suspaceflight/rocket-logger/rocket-logger-basic.brd

## EAGLE design rocket-logger-basic.brd (2015-02-23)

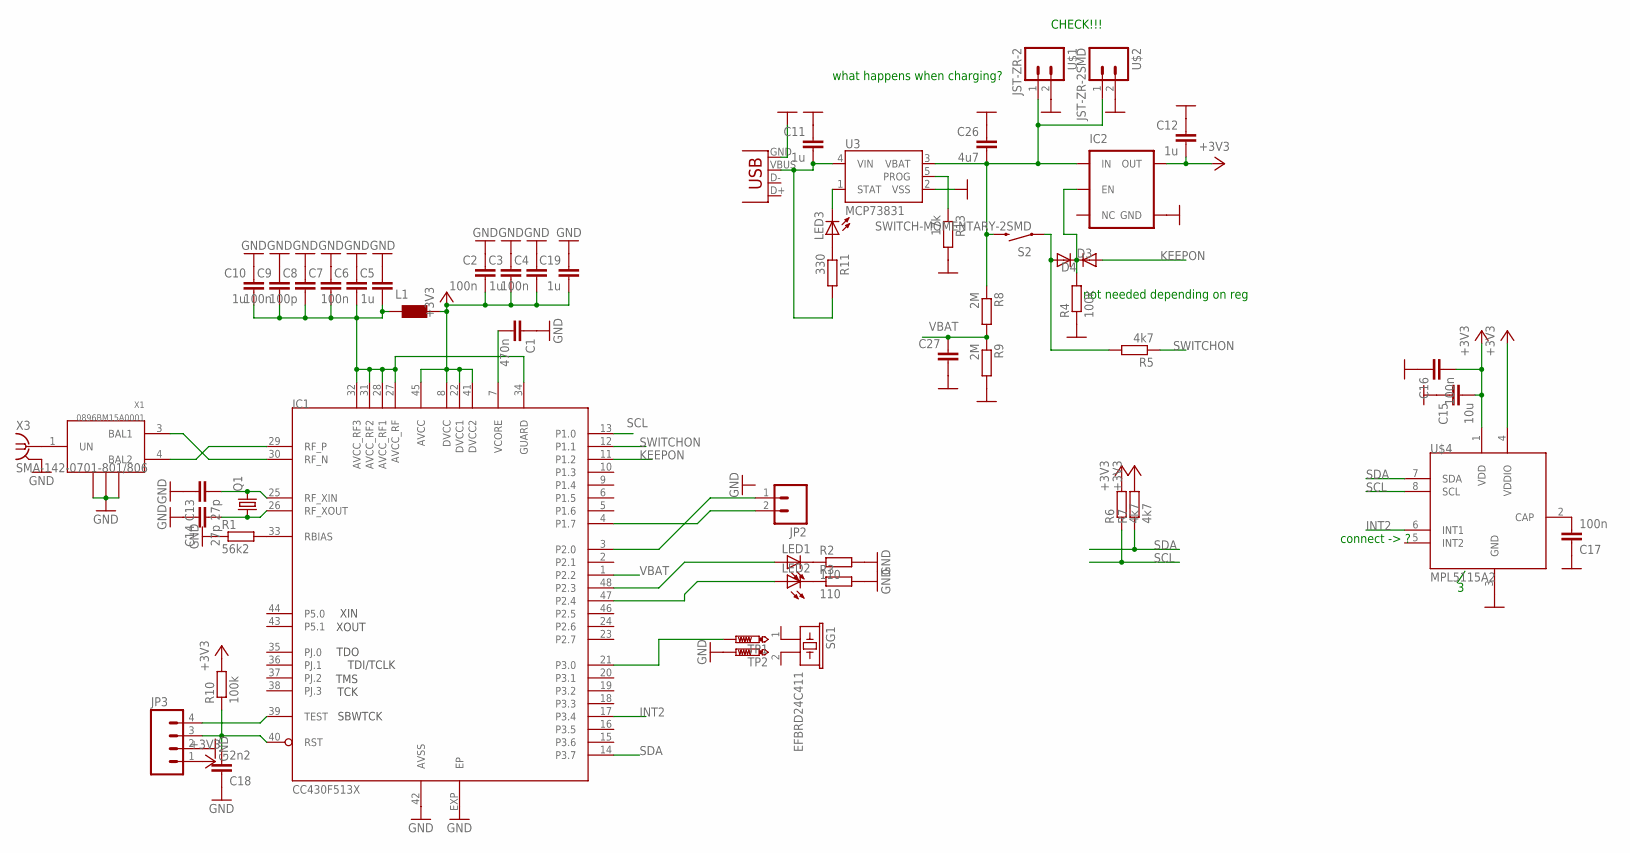
[picture p1: schematic rocket-logger-basic.sch]

Parts:
C1: 470n; C0402
C2, C4, C6, C9, C16, C17: 100n; C0402
C3, C5, C10, C11, C12, C19: 1u; C0402
C7, C27: C-EUC0402; C0402
C8: 100p; C0402
C13, C14: 27p; C0402
C15: 10u; C0402
C18: 2n2; C0402
C26: 4u7; C0402
D3, D4: DIODE-SOD523; SOD523
IC1: CC430F513X; QFN48
IC2: V_REG_TPS76433SOT23-5; SOT23-5
JP2: M02PTH; 1X02
JP3: M04PTH; 1X04
L1: WE-MK_0603; 0603
LED1, LED2, LED3: LED0603; LED-0603
Q1: CRYSTAL5X3; CRYSTAL-SMD-5X3
R1: 56k2; R0402
R2, R3: 110; R0402
R4, R10: 100k; R0402
R5, R6, R7: 4k7; R0402
R8, R9: 2M; R0402
R11: 330; R0402
R13: 17k; R0402
S2: SWITCH-MOMENTARY-2SMD; TACTILE_SWITCH_SMD
SG1: EFBRD24C411
TP1, TP2: PTR1B1,27; B1,27
U3: MCP73831; SOT23-5
U$1: JST-ZR-2
U$2: JST-ZR-2SMD; JST-ZR-2-SMD
U$4: MPL5115A2; LGA8
X1: 0896BM15A0001
X2: USB-MICROB
X3: SMA-142-0701-801/806; J502-ND-142-0701-801/806

Connections:
+3V3: C2.2, C3.2, C4.2, C12.2, C15.2, C16.2, C19.2, IC1.8 (DVCC), IC1.22 (DVCC1), IC1.41 (DVCC2), IC1.45 (AVCC), IC2.5 (OUT), JP3.1, L1.2, R6.2, R7.2, R10.2, U$4.1 (VDD), U$4.4 (VDDIO)
AVCC_RF2: C5.2, C6.2, C7.2, C8.2, C9.2, C10.2, IC1.27 (AVCC_RF), IC1.28 (AVCC_RF1), IC1.31 (AVCC_RF2), IC1.32 (AVCC_RF3), IC1.34 (GUARD), L1.1
GND: C1.1, C2.1, C3.1, C4.1, C5.1, C6.1, C7.1, C8.1, C9.1, C10.1, C11.1, C12.1, C13.1, C14.1, C15.1, C16.1, C17.1, C18.1, C19.1, C26.1, C27.2, IC1.42 (AVSS), IC1.EXP (EP), IC2.2 (GND), JP3.2, R1.1, R2.2, R3.2, R4.1, R9.2, R13.2, TP2.TP, U3.2 (VSS), U$1.2, U$2.2, U$4.3 (GND), X1.2 (GND2), X1.5 (GND), X1.6 (GND1), X2.GND, X3.G@1 (GND), X3.G@2 (GND), X3.G@3 (GND), X3.G@4 (GND)
INT2: IC1.17 (P3.4), U$4.6 (INT1)
KEEPON: D4.A, IC1.11 (P1.2)
unnamed: R13.1, U3.5 (PROG)
unnamed: C26.2, IC2.1 (IN), R8.1, S2.3 (2), U3.3 (VBAT), U$1.1, U$2.1
unnamed: IC1.30 (RF_N), X1.3 (BAL1)
unnamed: IC1.29 (RF_P), X1.4 (BAL2)
unnamed: IC1.33 (RBIAS), R1.2
unnamed: C13.2, IC1.25 (RF_XIN), Q1.3 (2)
unnamed: C14.2, IC1.26 (RF_XOUT), Q1.1
unnamed: X1.1 (UN), X3.1
unnamed: LED1.C, R2.1
unnamed: LED2.C, R3.1
unnamed: IC1.3 (P2.0), JP2.1
unnamed: IC1.4 (P1.7), JP2.2
unnamed: C17.2, U$4.2 (CAP)
unnamed: LED3.A, R11.1
unnamed: IC1.48 (P2.3), LED1.A
unnamed: C11.2, R11.2, U3.4 (VIN), X2.VBUS
unnamed: LED3.C, U3.1 (STAT)
unnamed: IC1.39 (TEST), JP3.4
unnamed: D3.A, R5.2, S2.1
unnamed: D3.C, D4.C, IC2.3 (EN), R4.2
unnamed: C18.2, IC1.40 (RST), JP3.3, R10.1
unnamed: IC1.47 (P2.4), LED2.A
unnamed: IC1.21 (P3.0), TP1.TP
SCL: IC1.13 (P1.0), R6.1, U$4.8 (SCL)
SDA: IC1.14 (P3.7), R7.1, U$4.7 (SDA)
SWITCHON: IC1.12 (P1.1), R5.1
VBAT: C27.1, IC1.1 (P2.2), R8.2, R9.1
VCORE: C1.2, IC1.7 (VCORE)

Notes on the sheet:
CHECK!!!
connect -> ?
what happens when charging?
not needed depending on reg

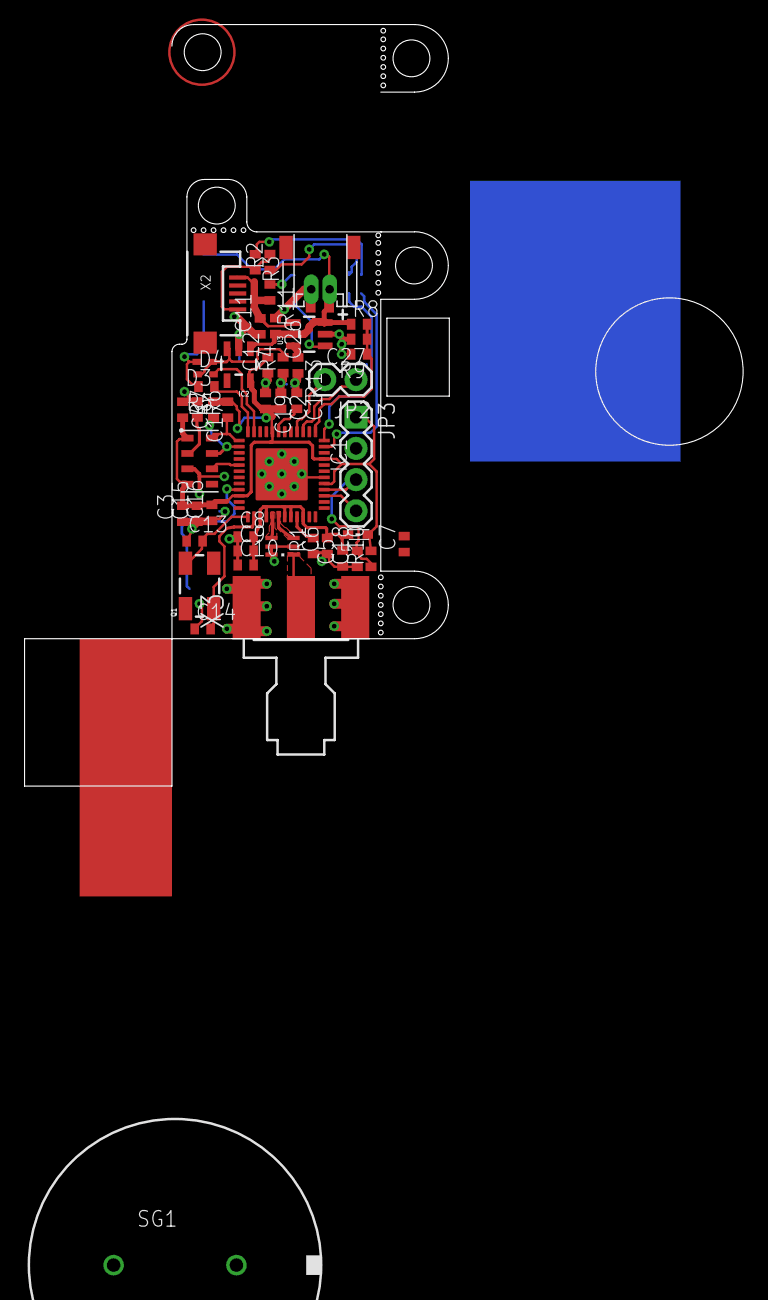
[picture p2: board rocket-logger-basic.brd from above]

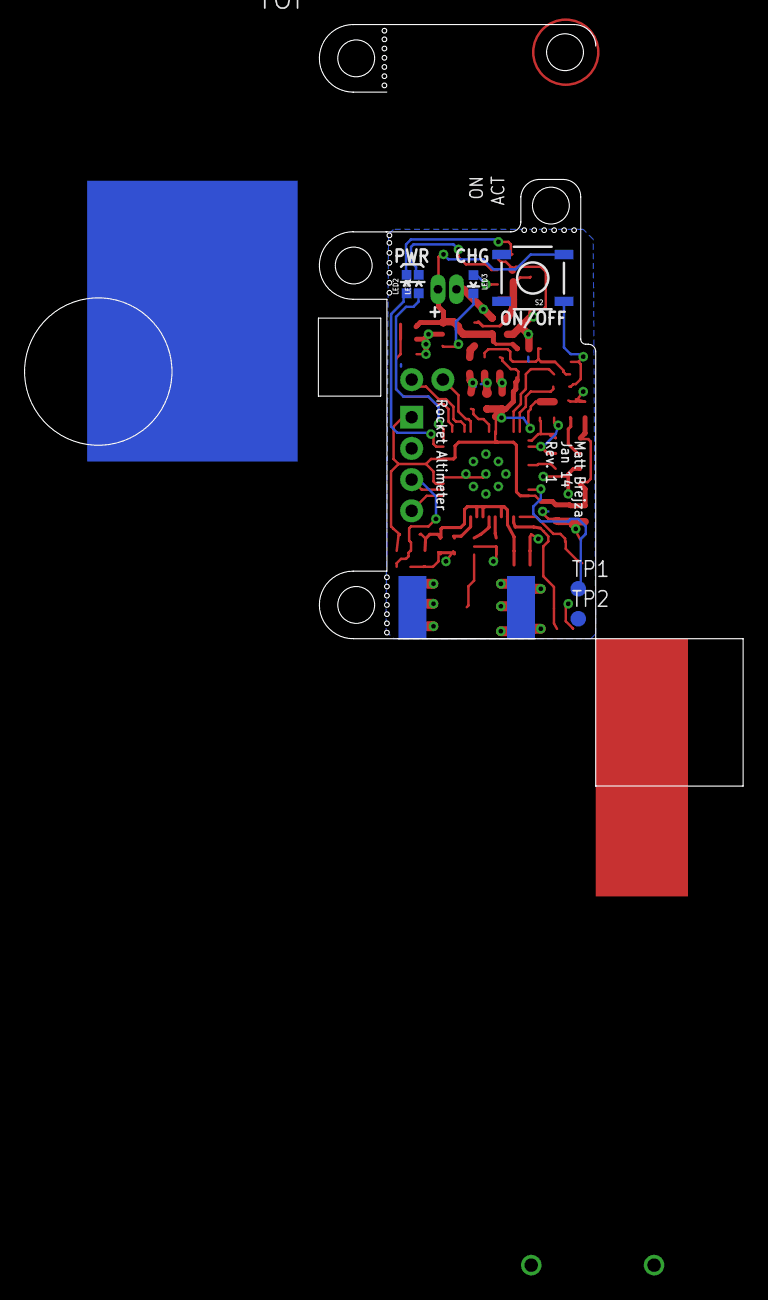
[picture p3: board rocket-logger-basic.brd from below]

Board: 2 copper layers, 34.5 x 49.4 mm, 55 parts (6 on the bottom side), 33 nets.
