suspaceflight/rocket-logger/rocket-logger.brd

## EAGLE design rocket-logger.brd (2014-01-06)

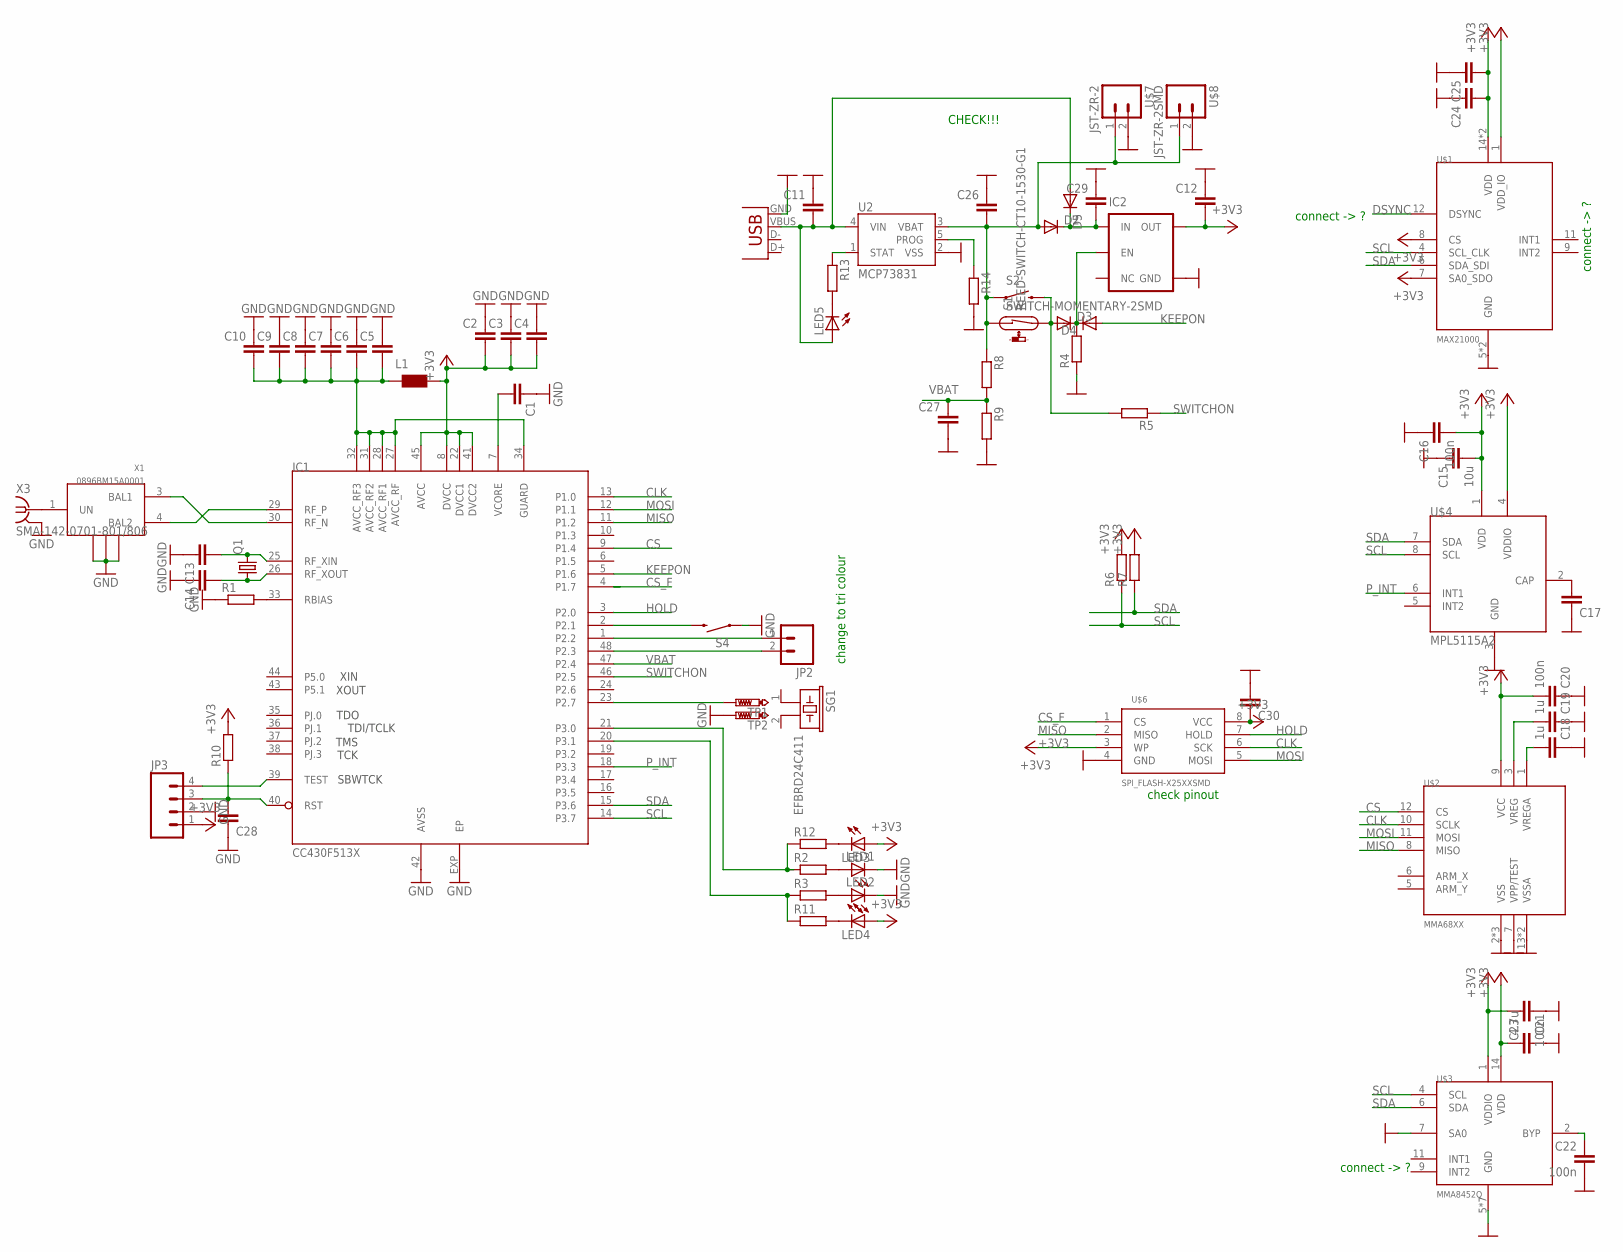
[picture p4: schematic rocket-logger.sch]

Parts:
C1, C2, C3, C4, C5, C6, C7, C8, C9, C10, C11, C12, C13, C14, C17, C24, C25, C26, C27, C28, C29, C30: C-EUC0402; C0402
C15: 10u; C0402
C16, C20, C22, C23: 100n; C0402
C18, C19: 1u; C0402
C21: 4.7u; C0402
D2, D3, D4, D5: DIODE-SOD523; SOD523
IC1: CC430F513X; QFN48
IC2: V_REG_TPS76433SOT23-5; SOT23-5
JP2: M02PTH; 1X02
JP3: M04PTH; 1X04
L1: WE-MK_0603; 0603
LED1, LED2, LED3, LED4, LED5: LED0603; LED-0603
Q1: CRYSTAL5X3; CRYSTAL-SMD-5X3
R1, R2, R3, R4, R5, R6, R7, R8, R9, R10, R11, R12, R13, R14: R-EU_R0402; R0402
S1: REED-SWITCH-CT10-1530-G1; CT10-G1
S2, S4: SWITCH-MOMENTARY-2SMD; TACTILE_SWITCH_SMD
SG1: EFBRD24C411
TP1, TP2: PTR1B1,27; B1,27
U2: MCP73831; SOT23-5
U$1: MAX21000; LGA16
U$2: MMA68XX; QFN16-6X6
U$3: MMA8452Q; QFN16-COL
U$4: MPL5115A2; LGA8
U$6: SPI_FLASH-X25XXSMD; SO08
U$7: JST-ZR-2
U$8: JST-ZR-2SMD; JST-ZR-2-SMD
X1: 0896BM15A0001
X2: USB-MICROB
X3: SMA-142-0701-801/806; J502-ND-142-0701-801/806

Connections:
+3V3: C2.2, C3.2, C4.2, C12.2, C15.2, C16.2, C20.2, C21.2, C23.1, C24.2, C25.2, C30.1, IC1.8 (DVCC), IC1.22 (DVCC1), IC1.41 (DVCC2), IC1.45 (AVCC), IC2.5 (OUT), JP3.1, L1.2, LED3.A, LED4.A, R6.2, R7.2, R10.2, U$1.1 (VDD_IO), U$1.7 (SA0_SDO), U$1.8 (CS), U$1.14 (VDD), U$1.15 (VDD), U$2.9 (VCC), U$3.1 (VDDIO), U$3.14 (VDD), U$4.1 (VDD), U$4.4 (VDDIO), U$6.3 (WP), U$6.8 (VCC)
AVCC_RF2: C5.2, C6.2, C7.2, C8.2, C9.2, C10.2, IC1.27 (AVCC_RF), IC1.28 (AVCC_RF1), IC1.31 (AVCC_RF2), IC1.32 (AVCC_RF3), IC1.34 (GUARD), L1.1
CLK: IC1.13 (P1.0), U$2.10 (SCLK), U$6.6 (SCK)
CS: IC1.9 (P1.4), U$2.12 (CS)
CS_F: IC1.4 (P1.7), U$6.1 (CS)
DSYNC: U$1.12 (DSYNC)
GND: C1.1, C2.1, C3.1, C4.1, C5.1, C6.1, C7.1, C8.1, C9.1, C10.1, C11.1, C12.1, C13.1, C14.1, C15.1, C16.1, C17.1, C18.1, C19.1, C20.1, C21.1, C22.2, C23.2, C24.1, C25.1, C26.1, C27.2, C28.1, C29.1, C30.2, IC1.42 (AVSS), IC1.EXP (EP), IC2.2 (GND), JP3.2, LED1.C, LED2.C, R1.1, R4.1, R9.2, R14.2, S4.1, TP2.TP, U2.2 (VSS), U$1.5 (GND), U$1.10 (GND), U$2.2 (VSS), U$2.4 (VSS), U$2.7 (VPP/TEST), U$2.13 (VSSA), U$2.16 (VSSA), U$2.17 (VSS), U$3.5 (GND), U$3.7 (SA0), U$3.8 (GND), U$3.10 (GND), U$3.12 (GND), U$3.13 (GND), U$3.15 (GND), U$3.16 (GND), U$4.3 (GND), U$6.4 (GND), U$7.2, U$8.2, X1.2 (GND2), X1.5 (GND), X1.6 (GND1), X2.GND, X3.G@1 (GND), X3.G@2 (GND), X3.G@3 (GND), X3.G@4 (GND)
HOLD: IC1.3 (P2.0), U$6.7 (HOLD)
KEEPON: D4.A, IC1.5 (P1.6)
MISO: IC1.11 (P1.2), U$2.8 (MISO), U$6.2 (MISO)
MOSI: IC1.12 (P1.1), U$2.11 (MOSI), U$6.5 (MOSI)
unnamed: C11.2, D5.A, LED5.A, U2.4 (VIN), X2.VBUS
unnamed: C26.2, D2.A, R8.1, S1.1, S2.1, U2.3 (VBAT), U$7.1, U$8.1
unnamed: IC1.30 (RF_N), X1.3 (BAL1)
unnamed: IC1.29 (RF_P), X1.4 (BAL2)
unnamed: IC1.33 (RBIAS), R1.2
unnamed: C13.2, IC1.25 (RF_XIN), Q1.3 (2)
unnamed: C14.2, IC1.26 (RF_XOUT), Q1.1
unnamed: X1.1 (UN), X3.1
unnamed: LED1.A, R2.2
unnamed: R13.1, U2.1 (STAT)
unnamed: IC1.1 (P2.2), JP2.1
unnamed: IC1.48 (P2.3), JP2.2
unnamed: C17.2, U$4.2 (CAP)
unnamed: C18.2, U$2.1 (VREGA)
unnamed: C19.2, U$2.3 (VREG)
unnamed: IC1.21 (P3.0), R2.1, R12.1
unnamed: IC1.20 (P3.1), R3.1, R11.1
unnamed: LED5.C, R13.2
unnamed: C22.1, U$3.2 (BYP)
unnamed: LED2.A, R3.2
unnamed: LED4.C, R11.2
unnamed: LED3.C, R12.2
unnamed: IC1.39 (TEST), JP3.4
unnamed: D3.A, R5.2, S1.2, S2.3 (2)
unnamed: D3.C, D4.C, IC2.3 (EN), R4.2
unnamed: C28.2, IC1.40 (RST), JP3.3, R10.1
unnamed: IC1.2 (P2.1), S4.3 (2)
unnamed: IC1.23 (P2.7), TP1.TP
unnamed: C29.2, D2.C, D5.C, IC2.1 (IN)
unnamed: R14.1, U2.5 (PROG)
P_INT: IC1.18 (P3.3), U$4.6 (INT1)
SCL: IC1.14 (P3.7), R6.1, U$1.4 (SCL_CLK), U$3.4 (SCL), U$4.8 (SCL)
SDA: IC1.15 (P3.6), R7.1, U$1.6 (SDA_SDI), U$3.6 (SDA), U$4.7 (SDA)
SWITCHON: IC1.46 (P2.5), R5.1
VBAT: C27.1, IC1.47 (P2.4), R8.2, R9.1
VCORE: C1.2, IC1.7 (VCORE)

Notes on the sheet:
CHECK!!!
connect -> ?
change to tri colour
check pinout

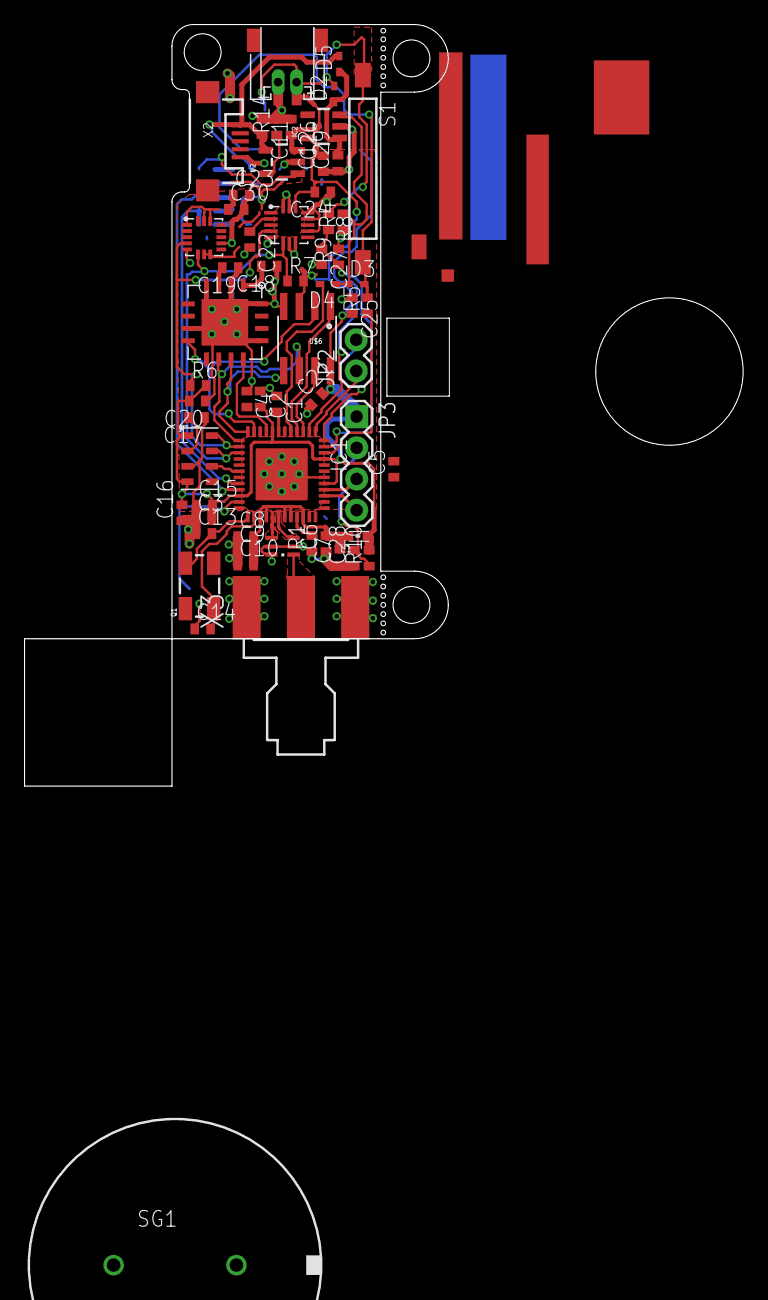
[picture p5: board rocket-logger.brd from above]

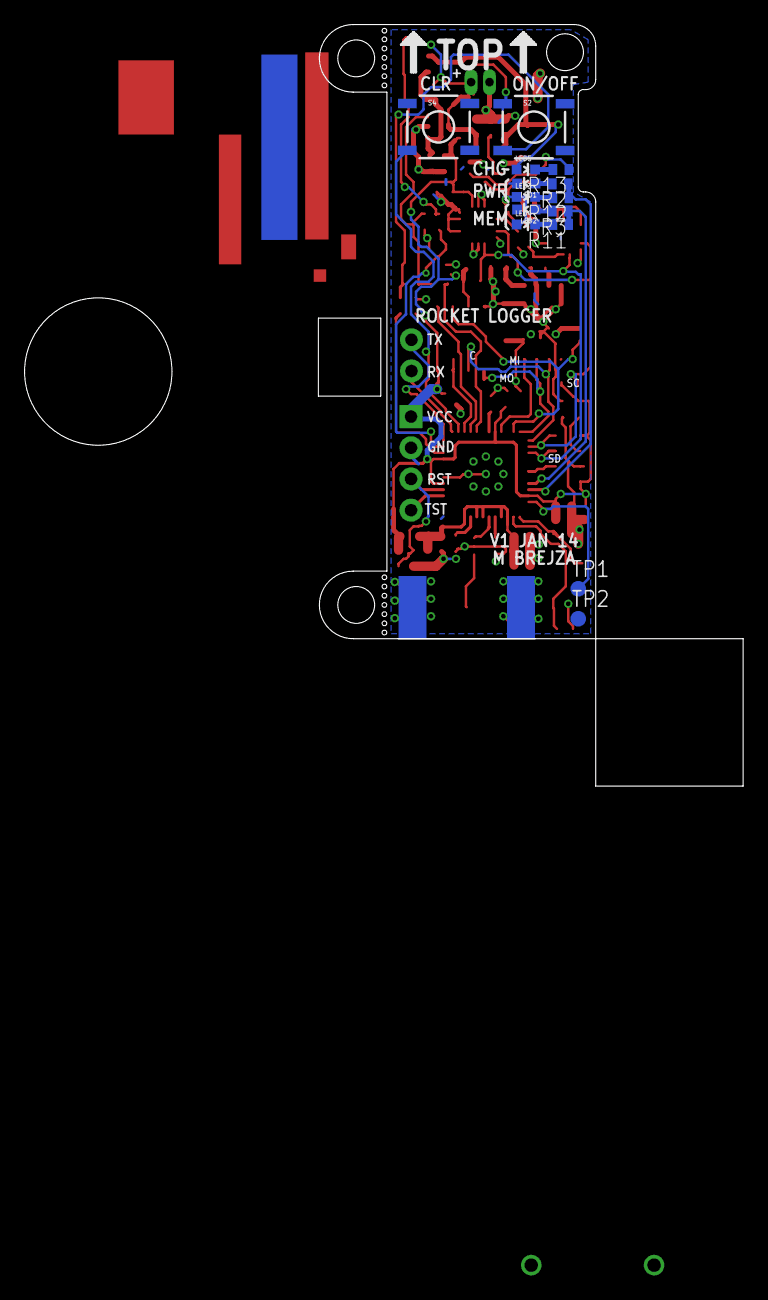
[picture p6: board rocket-logger.brd from below]

Board: 2 copper layers, 34.5 x 62.0 mm, 76 parts (14 on the bottom side), 46 nets.
