suspaceflight/rocket-logger/rocket-logger-merged.brd

## EAGLE design rocket-logger-merged.brd (2014-01-08)

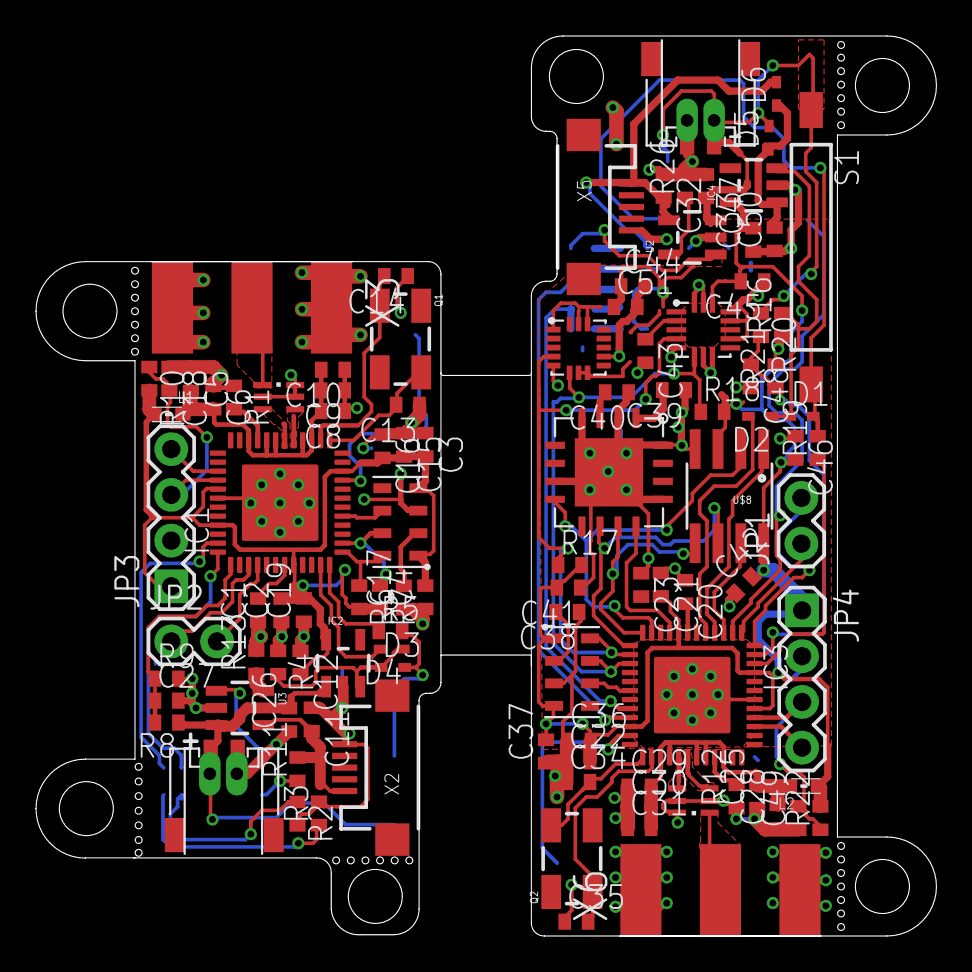
[picture p7: board rocket-logger-merged.brd from above]

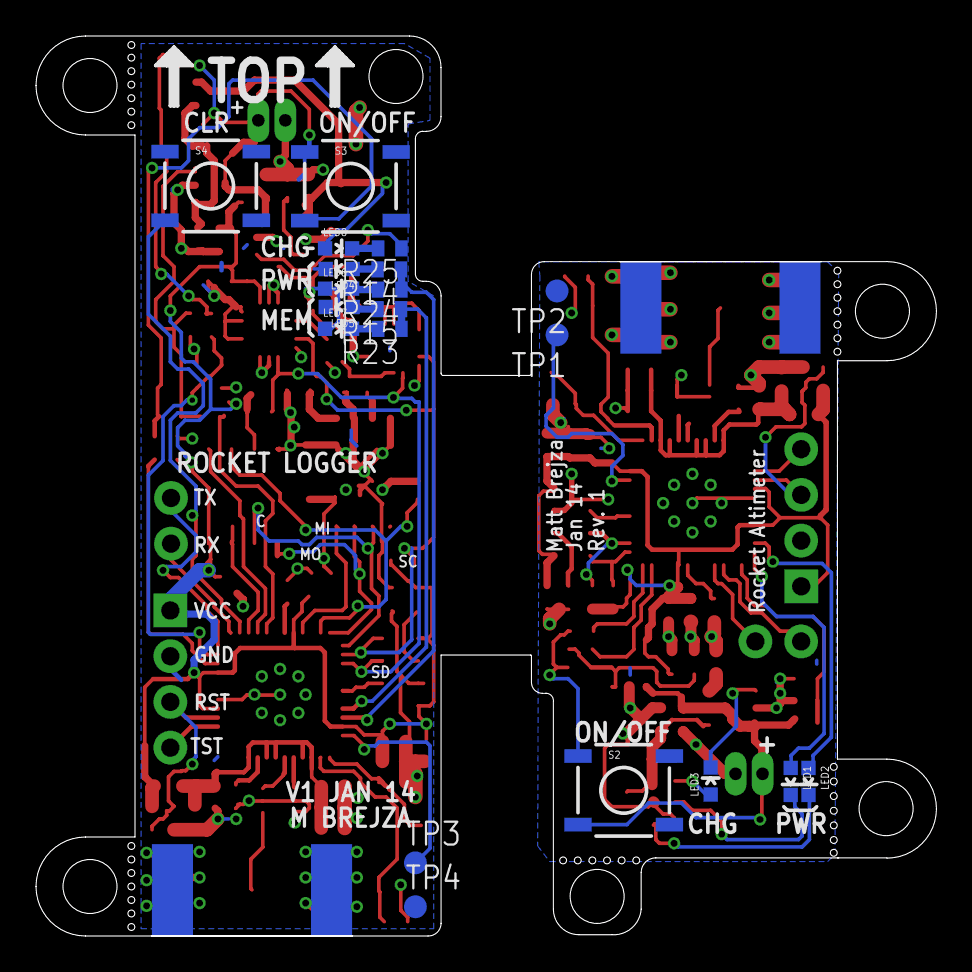
[picture p8: board rocket-logger-merged.brd from below]

Board: 2 copper layers, 50.0 x 50.0 mm, 127 parts (20 on the bottom side), 79 nets.

Parts:
C1, C2, C3, C4, C5, C6, C8, C9, C10, C11, C12, C13, C14, C17, C18, C19, C20, C21, C22, C23, C25, C26, C27, C28, C29, C30, C31, C32, C33, C34, C35, C38, C45, C46, C47, C48, C49, C50, C51: C0402
C15, C36: 10u; C0402
C16, C37, C41, C43, C44: 100n; C0402
C39, C40: 1u; C0402
C42: 4.7u; C0402
D1, D2, D3, D4, D5, D6: SOD523
IC1, IC3: CC430F513X; QFN48
IC2, IC4: SOT23-5
JP1, JP2: 1X02
JP3, JP4: 1X04
L1, L2: 0603
LED1, LED2, LED3, LED4, LED5, LED6, LED7, LED8: LED-0603
Q1, Q2: CRYSTAL-SMD-5X3
R1, R2, R3, R4, R5, R6, R7, R8, R9, R10, R11, R12, R13, R14, R15, R16, R17, R18, R19, R20, R21, R22, R23, R24, R25, R26: R0402
S1: REED-SWITCH-CT10-1530-G1; CT10-G1
S2, S3, S4: SWITCH-MOMENTARY-2SMD; TACTILE_SWITCH_SMD
TP1, TP2, TP3, TP4: PTR1B1,27; B1,27
U2, U3: MCP73831; SOT23-5
U$1, U$9: JST-ZR-2
U$2, U$10: JST-ZR-2SMD; JST-ZR-2-SMD
U$3: MAX21000; LGA16
U$4, U$7: MPL5115A2; LGA8
U$5: MMA68XX; QFN16-6X6
U$6: MMA8452Q; QFN16-COL
U$8: SPI_FLASH-X25XXSMD; SO08
X1, X4: 0896BM15A0001
X2, X5: USB-MICROB
X3, X6: SMA-142-0701-801/806; J502-ND-142-0701-801/806

Connections:
+3V1: C21.2, C22.2, C23.2, C33.2, C36.2, C37.2, C41.2, C42.2, C44.1, C45.2, C46.2, C51.1, IC3.8, IC3.22, IC3.41, IC3.45, IC4.5, JP4.1, L2.2, LED6.A, LED7.A, R17.2, R18.2, R22.2, U$3.1, U$3.7, U$3.8, U$3.14, U$3.15, U$5.9, U$6.1, U$6.14, U$7.1, U$7.4, U$8.3, U$8.8
+3V3: C2.2, C3.2, C4.2, C12.2, C15.2, C16.2, C19.2, IC1.8, IC1.22, IC1.41, IC1.45, IC2.5, JP3.1, L1.2, R6.2, R7.2, R10.2, U$4.1, U$4.4
AVCC_RF1: C25.2, C28.2, C29.2, C30.2, C31.2, IC3.27, IC3.28, IC3.31, IC3.32, IC3.34, L2.1
AVCC_RF2: C5.2, C6.2, C8.2, C9.2, C10.2, IC1.27, IC1.28, IC1.31, IC1.32, IC1.34, L1.1
CLK: IC3.13, U$5.10, U$8.6
CS: IC3.9, U$5.12
CS_F: IC3.4, U$8.1
GND: C1.1, C2.1, C3.1, C4.1, C5.1, C6.1, C8.1, C9.1, C10.1, C11.1, C12.1, C13.1, C14.1, C15.1, C16.1, C17.1, C18.1, C19.1, C26.1, C27.2, IC1.42, IC1.EXP, IC2.2, JP3.2, R1.1, R2.2, R3.2, R4.1, R9.2, R13.2, TP2.TP, U3.2, U$1.2, U$2.2, U$4.3, X1.2, X1.5, X1.6, X2.GND, X3.G@1, X3.G@2, X3.G@3, X3.G@4
GND1: C20.1, C21.1, C22.1, C23.1, C25.1, C28.1, C29.1, C30.1, C31.1, C32.1, C33.1, C34.1, C35.1, C36.1, C37.1, C38.1, C39.1, C40.1, C41.1, C42.1, C43.2, C44.2, C45.1, C46.1, C47.1, C48.2, C49.1, C50.1, C51.2, IC3.42, IC3.EXP, IC4.2, JP4.2, LED4.C, LED5.C, R12.1, R16.1, R21.2, R26.2, S4.1, TP4.TP, U2.2, U$3.5, U$3.10, U$5.2, U$5.4, U$5.7, U$5.13, U$5.16, U$5.17, U$6.5, U$6.7, U$6.8, U$6.10, U$6.12, U$6.13, U$6.15, U$6.16, U$7.3, U$8.4, U$9.2, U$10.2, X4.2, X4.5, X4.6, X5.GND, X6.G@1, X6.G@2, X6.G@3, X6.G@4
HOLD: IC3.3, U$8.7
INT2: IC1.17, U$4.6
KEEPON: D4.A, IC1.11
KEEPON1: D2.A, IC3.5
MISO: IC3.11, U$5.8, U$8.2
MOSI: IC3.12, U$5.11, U$8.5
unnamed: R13.1, U3.5
unnamed: C26.2, IC2.1, R8.1, S2.3, U3.3, U$1.1, U$2.1
unnamed: IC1.30, X1.3
unnamed: IC1.29, X1.4
unnamed: IC1.33, R1.2
unnamed: C13.2, IC1.25, Q1.3
unnamed: C14.2, IC1.26, Q1.1
unnamed: X1.1, X3.1
unnamed: LED1.C, R2.1
unnamed: LED2.C, R3.1
unnamed: IC1.3, JP2.1
unnamed: IC1.4, JP2.2
unnamed: C17.2, U$4.2
unnamed: C32.2, D6.A, LED8.A, U2.4, X5.VBUS
unnamed: LED3.A, R11.1
unnamed: IC1.48, LED1.A
unnamed: C47.2, D5.A, R20.1, S1.1, S3.1, U2.3, U$9.1, U$10.1
unnamed: C11.2, R11.2, U3.4, X2.VBUS
unnamed: LED3.C, U3.1
unnamed: IC3.30, X4.3
unnamed: IC3.33, R12.2
unnamed: C34.2, IC3.25, Q2.3
unnamed: IC1.39, JP3.4
unnamed: D3.A, R5.2, S2.1
unnamed: D3.C, D4.C, IC2.3, R4.2
unnamed: C18.2, IC1.40, JP3.3, R10.1
unnamed: C35.2, IC3.26, Q2.1
unnamed: IC1.47, LED2.A
unnamed: IC1.21, TP1.TP
unnamed: X4.1, X6.1
unnamed: IC3.29, X4.4
unnamed: C38.2, U$7.2
unnamed: C39.2, U$5.1
unnamed: C40.2, U$5.3
unnamed: C43.1, U$6.2
unnamed: IC3.21, R14.1, R24.1
unnamed: IC3.20, R15.1, R23.1
unnamed: IC3.1, JP1.1
unnamed: IC3.48, JP1.2
unnamed: D1.A, R19.2, S1.2, S3.3
unnamed: D1.C, D2.C, IC4.3, R16.2
unnamed: IC3.39, JP4.4
unnamed: C49.2, IC3.40, JP4.3, R22.1
unnamed: IC3.2, S4.3
unnamed: IC3.23, TP3.TP
unnamed: LED5.A, R15.2
unnamed: LED7.C, R23.2
unnamed: LED4.A, R14.2
unnamed: LED6.C, R24.2
unnamed: LED8.C, R25.2
unnamed: C50.2, D5.C, D6.C, IC4.1
unnamed: R25.1, U2.1
unnamed: R26.1, U2.5
P_INT: IC3.18, U$7.6
SCL: IC1.13, R6.1, U$4.8
SCL1: IC3.14, R17.1, U$3.4, U$6.4, U$7.8
SDA: IC1.14, R7.1, U$4.7
SDA1: IC3.15, R18.1, U$3.6, U$6.6, U$7.7
SWITCHON: IC1.12, R5.1
SWITCHON1: IC3.46, R19.1
VBAT: C27.1, IC1.1, R8.2, R9.1
VBAT1: C48.1, IC3.47, R20.2, R21.1
VCORE: C1.2, IC1.7
VCORE1: C20.2, IC3.7
