suspaceflight/rocket-logger/firmware-rx/RF1A.c

#include "RF1A.h"
#include <avr/io.h>

#define CS_LOW (PORTB &= ~(1<<4))
#define CS_HIGH (PORTB |= (1<<4))

// *****************************************************************************
// @fn          Strobe
// @brief       Send a command strobe to the radio. Includes workaround for RF1A7
// @param       uint8_t strobe        The strobe command to be sent
// @return      uint8_t statusByte    The status byte that follows the strobe
// *****************************************************************************
/*
uint8_t Strobe(uint8_t strobe)
{
  uint8_t statusByte = 0;
  unsigned int  gdo_state;
  
  // Check for valid strobe command 
  if((strobe == 0xBD) || ((strobe >= RF_SRES) && (strobe <= RF_SNOP)))
  {
    // Clear the Status read flag 
    RF1AIFCTL1 &= ~(RFSTATIFG);    
    
    // Wait for radio to be ready for next instruction
    while( !(RF1AIFCTL1 & RFINSTRIFG));
    
    // Write the strobe instruction
    if ((strobe > RF_SRES) && (strobe < RF_SNOP))
    {
      gdo_state = ReadSingleReg(IOCFG2);    // buffer IOCFG2 state
      WriteSingleReg(IOCFG2, 0x29);         // chip-ready to GDO2
      
      RF1AINSTRB = strobe; 
      if ( (RF1AIN&0x04)== 0x04 )           // chip at sleep mode
      {
        if ( (strobe == RF_SXOFF) || (strobe == RF_SPWD) || (strobe == RF_SWOR) ) { }
        else  	
        {
          while ((RF1AIN&0x04)== 0x04);     // chip-ready ?
          // Delay for ~810usec at 1.05MHz CPU clock, see erratum RF1A7
          __delay_cycles(850);	            
        }
      }
      WriteSingleReg(IOCFG2, gdo_state);    // restore IOCFG2 setting
    
      while( !(RF1AIFCTL1 & RFSTATIFG) );
    }
    else		                    // chip active mode (SRES)
    {	
      RF1AINSTRB = strobe; 	   
    }
    statusByte = RF1ASTATB;
  }
  return statusByte;
}*/
uint8_t Strobe(uint8_t cmd)
{
	CS_LOW;
	uint8_t out = spi_tx_rx(cmd);

	CS_HIGH;
	return(out);
}

// *****************************************************************************
// @fn          ReadSingleReg
// @brief       Read a single byte from the radio register
// @param       uint8_t addr      Target radio register address
// @return      uint8_t data_out  Value of byte that was read
// *****************************************************************************
//uint8_t ReadSingleReg(uint8_t addr)
//{
//  uint8_t data_out;
//  
//  // Check for valid configuration register address, 0x3E refers to PATABLE 
//  if ((addr <= 0x2E) || (addr == 0x3E))
//    // Send address + Instruction + 1 dummy byte (auto-read)
//    RF1AINSTR1B = (addr | RF_SNGLREGRD);    
//  else
//    // Send address + Instruction + 1 dummy byte (auto-read)
//    RF1AINSTR1B = (addr | RF_STATREGRD);    
//  
//  while (!(RF1AIFCTL1 & RFDOUTIFG) );
//  data_out = RF1ADOUTB;                    // Read data and clears the RFDOUTIFG
//
// return data_out;
//}
uint8_t ReadSingleReg(uint8_t addr)
{
	CS_LOW;
	uint8_t out;
	spi_tx_rx(addr | RF_STATREGRD);
	out = spi_tx_rx(0);
	CS_HIGH;

    return(out);
}

// *****************************************************************************
// @fn          WriteSingleReg
// @brief       Write a single byte to a radio register
// @param       uint8_t addr      Target radio register address
// @param       uint8_t value     Value to be written
// @return      none
// *****************************************************************************
void WriteSingleReg(uint8_t addr, uint8_t value) //done
{   
	CS_LOW;
	spi_tx(addr | RF_SNGLREGWR);	    // Send address + Instruction
	spi_tx(value); 			    // Write data in 
	CS_HIGH;
}
        
// *****************************************************************************
// @fn          ReadBurstReg
// @brief       Read multiple bytes to the radio registers
// @param       uint8_t addr      Beginning address of burst read
// @param       uint8_t *buffer   Pointer to data table
// @param       uint8_t count     Number of bytes to be read
// @return      none
// *****************************************************************************
/*void ReadBurstReg(uint8_t addr, uint8_t *buffer, uint8_t count)
{
  unsigned int i;
  if(count > 0)
  {
    while (!(RF1AIFCTL1 & RFINSTRIFG));       // Wait for INSTRIFG
    RF1AINSTR1B = (addr | RF_REGRD);          // Send addr of first conf. reg. to be read 
                                              // ... and the burst-register read instruction
    for (i = 0; i < (count-1); i++)
    {
      while (!(RFDOUTIFG&RF1AIFCTL1));        // Wait for the Radio Core to update the RF1ADOUTB reg
      buffer[i] = RF1ADOUT1B;                 // Read DOUT from Radio Core + clears RFDOUTIFG
                                              // Also initiates auo-read for next DOUT byte
    }
    buffer[count-1] = RF1ADOUT0B;             // Store the last DOUT from Radio Core  
  }
}  
*/
void ReadBurstReg(uint8_t addr, uint8_t *buffer, uint8_t count)
{

	uint8_t i = 0; 
	CS_LOW;
	spi_tx(addr | RF_REGRD);
	for (i = 0; i < count; i++)
	{
		buffer[i] = spi_tx_rx(0);
	}
	CS_HIGH;

}


// *****************************************************************************
// @fn          WriteBurstReg
// @brief       Write multiple bytes to the radio registers
// @param       uint8_t addr      Beginning address of burst write
// @param       uint8_t *buffer   Pointer to data table
// @param       uint8_t count     Number of bytes to be written
// @return      none
// *****************************************************************************
/*
void WriteBurstReg(uint8_t addr, uint8_t *buffer, uint8_t count)
{  
  uint8_t i;

  if(count > 0)
  {
    while (!(RF1AIFCTL1 & RFINSTRIFG));       // Wait for the Radio to be ready for next instruction
    RF1AINSTRW = ((addr | RF_REGWR)<<8 ) + buffer[0]; // Send address + Instruction
  
    for (i = 1; i < count; i++)
    {
      RF1ADINB = buffer[i];                   // Send data
      while (!(RFDINIFG & RF1AIFCTL1));       // Wait for TX to finish
    } 
    i = RF1ADOUTB;                            // Reset RFDOUTIFG flag which contains status byte  
  }
}
*/
void WriteBurstReg(uint8_t addr, uint8_t *buffer, uint8_t count)
{
	volatile char i = 0; 
	CS_LOW;
	spi_tx(addr | RF_REGWR);
	for (i = 0; i < count; i++)
	{
		spi_tx(buffer[i]);
	}
	CS_HIGH;

}

// *****************************************************************************
// @fn          ResetRadioCore
// @brief       Reset the radio core using RF_SRES command
// @param       none
// @return      none
// *****************************************************************************
void ResetRadioCore (void)
{
  Strobe(RF_SRES);                          // Reset the Radio Core
  Strobe(RF_SNOP);                          // Reset Radio Pointer
}

// *****************************************************************************
// @fn          WriteRfSettings
// @brief       Write the minimum set of RF configuration register settings
// @param       RF_SETTINGS *pRfSettings  Pointer to the structure that holds the rf settings
// @return      none
// *****************************************************************************
void WriteRfSettings(RF_SETTINGS *pRfSettings) {
    WriteSingleReg(FSCTRL1,  pRfSettings->fsctrl1);
    WriteSingleReg(FSCTRL0,  pRfSettings->fsctrl0);
    WriteSingleReg(FREQ2,    pRfSettings->freq2);
    WriteSingleReg(FREQ1,    pRfSettings->freq1);
    WriteSingleReg(FREQ0,    pRfSettings->freq0);
    WriteSingleReg(MDMCFG4,  pRfSettings->mdmcfg4);
    WriteSingleReg(MDMCFG3,  pRfSettings->mdmcfg3);
    WriteSingleReg(MDMCFG2,  pRfSettings->mdmcfg2);
    WriteSingleReg(MDMCFG1,  pRfSettings->mdmcfg1);
    WriteSingleReg(MDMCFG0,  pRfSettings->mdmcfg0);
    WriteSingleReg(CHANNR,   pRfSettings->channr);
    WriteSingleReg(DEVIATN,  pRfSettings->deviatn);
    WriteSingleReg(FREND1,   pRfSettings->frend1);
    WriteSingleReg(FREND0,   pRfSettings->frend0);
    WriteSingleReg(MCSM0 ,   pRfSettings->mcsm0);
    WriteSingleReg(FOCCFG,   pRfSettings->foccfg);
    WriteSingleReg(BSCFG,    pRfSettings->bscfg);
    WriteSingleReg(AGCCTRL2, pRfSettings->agcctrl2);
    WriteSingleReg(AGCCTRL1, pRfSettings->agcctrl1);
    WriteSingleReg(AGCCTRL0, pRfSettings->agcctrl0);
    WriteSingleReg(FSCAL3,   pRfSettings->fscal3);
    WriteSingleReg(FSCAL2,   pRfSettings->fscal2);
    WriteSingleReg(FSCAL1,   pRfSettings->fscal1);
    WriteSingleReg(FSCAL0,   pRfSettings->fscal0);
    WriteSingleReg(FSTEST,   pRfSettings->fstest);
    WriteSingleReg(TEST2,    pRfSettings->test2);
    WriteSingleReg(TEST1,    pRfSettings->test1);
    WriteSingleReg(TEST0,    pRfSettings->test0);
    WriteSingleReg(FIFOTHR,  pRfSettings->fifothr);
    WriteSingleReg(IOCFG2,   pRfSettings->iocfg2);
    WriteSingleReg(IOCFG0,   pRfSettings->iocfg0);
    WriteSingleReg(PKTCTRL1, pRfSettings->pktctrl1);
    WriteSingleReg(PKTCTRL0, pRfSettings->pktctrl0);
    WriteSingleReg(ADDR,     pRfSettings->addr);
    WriteSingleReg(PKTLEN,   pRfSettings->pktlen);
}

// *****************************************************************************
// @fn          WritePATable
// @brief       Write data to power table
// @param       uint8_t value		Value to write
// @return      none
// *****************************************************************************
void WriteSinglePATable(uint8_t value)
{
	CS_LOW;
	spi_tx(0x3E);
	spi_tx(value);
	spi_tx(RF_SNOP);
	CS_HIGH;

}

// *****************************************************************************
// @fn          WritePATable
// @brief       Write to multiple locations in power table 
// @param       uint8_t *buffer	Pointer to the table of values to be written 
// @param       uint8_t count	Number of values to be written
// @return      none
// *****************************************************************************
/*
void WriteBurstPATable(uint8_t *buffer, uint8_t count)
{
  volatile char i = 0; 
  
  while( !(RF1AIFCTL1 & RFINSTRIFG));
  RF1AINSTRW = 0x7E00 + buffer[i];          // PA Table burst write   

  for (i = 1; i < count; i++)
  {
    RF1ADINB = buffer[i];                   // Send data
    while (!(RFDINIFG & RF1AIFCTL1));       // Wait for TX to finish
  } 
  i = RF1ADOUTB;                            // Reset RFDOUTIFG flag which contains status byte

  while( !(RF1AIFCTL1 & RFINSTRIFG));
  RF1AINSTRB = RF_SNOP;                     // reset PA Table pointer
}
*/
void WriteBurstPATable(uint8_t *buffer, uint8_t count)
{
	volatile char i = 0; 
	CS_LOW;
	spi_tx(0x7E);
	for (i = 0; i < count; i++)
	{
		spi_tx(buffer[i]);
	}
	spi_tx(RF_SNOP);
	CS_HIGH;

}

void init_spi_master(void)
{
	DDRB = _BV(PB4) | _BV(PB5) | _BV(PB7);
	CS_HIGH;
	SPCR = _BV(SPE) | _BV(MSTR) | _BV(SPR0); /* F_SCK = F_CPU/16 = 750 kHz */
}

void spi_tx(uint8_t b)
{
	SPDR = b;
	while(!(SPSR & _BV(SPIF)));
}

uint8_t spi_tx_rx(uint8_t b)
{
	SPDR = b;
	while(!(SPSR & _BV(SPIF)));
	return SPDR;
}


uint8_t spi_rx(void) {
	while(!(SPSR & _BV(SPIF)));
	return SPDR;
}
