suspaceflight/rocket-logger/firmware/I2Croutines.c

/******************************************************************************/
/*  Communication with an EEPROM (e.g. 2465) via I2C bus                      */
/*  The I2C module of the MSP430F2274 is used to communicate with the EEPROM. */
/*  The "Byte Write", "Page Write", "Current Address Read", "Random Read",    */
/*  "Sequential Read" and "Acknowledge Polling" commands or the EEPROM are    */
/*  realized.                                                                 */
/*                                                                            */
/*  developed with IAR Embedded Workbench V5.20.1                             */
/*                                                                            */
/*  Texas Instruments                                                         */
/*  William Goh                                                               */
/*  March 2011                                                                */
/*----------------------------------------------------------------------------*/
/*  updates                                                                   */
/*    Jan 2005:                                                               */
/*        - updated initialization sequence                                   */
/*    March 2009:                                                             */
/*        - updated code for 2xx USCI module                                  */
/*        - added Page Write and Sequential Read functions                    */
/*    March 2011:                                                             */
/*        - Fixed Random and Sequential Reads to Restart                      */
/*        - Added Page Write to support greater than 256 bytes                */
/*******************************************************************************
;
; THIS PROGRAM IS PROVIDED "AS IS". TI MAKES NO WARRANTIES OR
; REPRESENTATIONS, EITHER EXPRESS, IMPLIED OR STATUTORY,
; INCLUDING ANY IMPLIED WARRANTIES OF MERCHANTABILITY, FITNESS
; FOR A PARTICULAR PURPOSE, LACK OF VIRUSES, ACCURACY OR
; COMPLETENESS OF RESPONSES, RESULTS AND LACK OF NEGLIGENCE.
; TI DISCLAIMS ANY WARRANTY OF TITLE, QUIET ENJOYMENT, QUIET
; POSSESSION, AND NON-INFRINGEMENT OF ANY THIRD PARTY
; INTELLECTUAL PROPERTY RIGHTS WITH REGARD TO THE PROGRAM OR
; YOUR USE OF THE PROGRAM.
;
; IN NO EVENT SHALL TI BE LIABLE FOR ANY SPECIAL, INCIDENTAL,
; CONSEQUENTIAL OR INDIRECT DAMAGES, HOWEVER CAUSED, ON ANY
; THEORY OF LIABILITY AND WHETHER OR NOT TI HAS BEEN ADVISED
; OF THE POSSIBILITY OF SUCH DAMAGES, ARISING IN ANY WAY OUT
; OF THIS AGREEMENT, THE PROGRAM, OR YOUR USE OF THE PROGRAM.
; EXCLUDED DAMAGES INCLUDE, BUT ARE NOT LIMITED TO, COST OF
; REMOVAL OR REINSTALLATION, COMPUTER TIME, LABOR COSTS, LOSS
; OF GOODWILL, LOSS OF PROFITS, LOSS OF SAVINGS, OR LOSS OF
; USE OR INTERRUPTION OF BUSINESS. IN NO EVENT WILL TI'S
; AGGREGATE LIABILITY UNDER THIS AGREEMENT OR ARISING OUT OF
; YOUR USE OF THE PROGRAM EXCEED FIVE HUNDRED DOLLARS
; (U.S.$500).
;
; Unless otherwise stated, the Program written and copyrighted
; by Texas Instruments is distributed as "freeware".  You may,
; only under TI's copyright in the Program, use and modify the
; Program without any charge or restriction.  You may
; distribute to third parties, provided that you transfer a
; copy of this license to the third party and the third party
; agrees to these terms by its first use of the Program. You
; must reproduce the copyright notice and any other legend of
; ownership on each copy or partial copy, of the Program.
;
; You acknowledge and agree that the Program contains
; copyrighted material, trade secrets and other TI proprietary
; information and is protected by copyright laws,
; international copyright treaties, and trade secret laws, as
; well as other intellectual property laws.  To protect TI's
; rights in the Program, you agree not to decompile, reverse
; engineer, disassemble or otherwise translate any object code
; versions of the Program to a human-readable form.  You agree
; that in no event will you alter, remove or destroy any
; copyright notice included in the Program.  TI reserves all
; rights not specifically granted under this license. Except
; as specifically provided herein, nothing in this agreement
; shall be construed as conferring by implication, estoppel,
; or otherwise, upon you, any license or other right under any
; TI patents, copyrights or trade secrets.
;
; You may not use the Program in non-TI devices.
;
******************************************************************************/
#include "msp430.h"
#include "I2Croutines.h"

#define     MAXPAGEWRITE   64

int PtrTransmit;
unsigned char I2CBufferArray[66];
unsigned char I2CBuffer;
unsigned char* rx_ptr;
unsigned int rx_remain;

/*----------------------------------------------------------------------------*/
// Description:
//   Initialization of the I2C Module
/*----------------------------------------------------------------------------*/
void InitI2C(unsigned char eeprom_i2c_address)
{
  I2C_PORT_SEL |= SDA_PIN + SCL_PIN;        // Assign I2C pins to USCI_B0

  // Recommended initialisation steps of I2C module as shown in User Guide:
  UCB0CTL1 |= UCSWRST;                      // Enable SW reset
  UCB0CTL0 = UCMST + UCMODE_3 + UCSYNC;     // I2C Master, synchronous mode
  UCB0CTL1 = UCSSEL_2 + UCTR + UCSWRST;     // Use SMCLK, TX mode, keep SW reset
  UCB0BR0 = SCL_CLOCK_DIV;                  // fSCL = SMCLK/12 = ~100kHz
  UCB0BR1 = 0;
  UCB0I2CSA  = eeprom_i2c_address;          // define Slave Address
                                            // In this case the Slave Address
                                            // defines the control byte that is
                                            // sent to the EEPROM.
  UCB0I2COA = 0x01A5;                       // own address.
  UCB0CTL1 &= ~UCSWRST;                     // Clear SW reset, resume operation
/*
  if (UCB0STAT & UCBBUSY)                   // test if bus to be free
  {                                         // otherwise a manual Clock on is
                                            // generated
    I2C_PORT_SEL &= ~SCL_PIN;               // Select Port function for SCL
    I2C_PORT_OUT &= ~SCL_PIN;               //
    I2C_PORT_DIR |= SCL_PIN;                // drive SCL low
    I2C_PORT_SEL |= SDA_PIN + SCL_PIN;      // select module function for the
                                            // used I2C pins
  }; */
}

/*---------------------------------------------------------------------------*/
// Description:
//   Initialization of the I2C Module for Write operation.
/*---------------------------------------------------------------------------*/
void I2CWriteInit(void)
{
  UCB0CTL1 |= UCTR;                         // UCTR=1 => Transmit Mode (R/W bit = 0)
  UCB0IFG &= ~UCTXIFG;
  UCB0IE &= ~UCRXIE;                         // disable Receive ready interrupt
  UCB0IE |= UCTXIE;                          // enable Transmit ready interrupt
}

/*----------------------------------------------------------------------------*/
// Description:
//   Initialization of the I2C Module for Read operation.
/*----------------------------------------------------------------------------*/
void I2CReadInit(void)
{
  UCB0CTL1 &= ~UCTR;                        // UCTR=0 => Receive Mode (R/W bit = 1)
  UCB0IFG &= ~UCRXIE;
  UCB0IE &= ~UCTXIE;                         // disable Transmit ready interrupt
  UCB0IE |= UCRXIE;                          // enable Receive ready interrupt
}

/*----------------------------------------------------------------------------*/
// Description:
//   Byte Write Operation. The communication via the I2C bus with an EEPROM
//   (2465) is realized. A data byte is written into a user defined address.
/*----------------------------------------------------------------------------*/
void EEPROM_ByteWrite(unsigned int Address, unsigned char Data)
{
  unsigned char adr_hi;
  unsigned char adr_lo;

  while (UCB0STAT & UCBUSY);                // wait until I2C module has
                                            // finished all operations.

  adr_hi = Address >> 8;                    // calculate high byte
  adr_lo = Address & 0xFF;                  // and low byte of address

  I2CBufferArray[2] = adr_hi;               // Low byte address.
  I2CBufferArray[1] = adr_lo;               // High byte address.
  I2CBufferArray[0] = Data;
  PtrTransmit = 1;                          // set I2CBufferArray Pointer

  I2CWriteInit();
  UCB0CTL1 |= UCTXSTT;                      // start condition generation
                                            // => I2C communication is started
  __bis_SR_register(LPM0_bits + GIE);       // Enter LPM0 w/ interrupts
  UCB0CTL1 |= UCTXSTP;                      // I2C stop condition
  while(UCB0CTL1 & UCTXSTP);                // Ensure stop condition got sent
}

/*----------------------------------------------------------------------------*/
// Description:
//   Page Write Operation. The communication via the I2C bus with an EEPROM
//   (24xx65) is realized. A data byte is written into a user defined address.
/*----------------------------------------------------------------------------*/
/*
void EEPROM_PageWrite(unsigned int StartAddress, unsigned char * Data, unsigned int Size)
{
  volatile unsigned int i = 0;
  volatile unsigned char counterI2cBuffer;
  unsigned char adr_hi;
  unsigned char adr_lo;
  unsigned int currentAddress = StartAddress;
  unsigned int currentSize = Size;
  unsigned int bufferPtr = 0;
  unsigned char moreDataToRead = 1;

  while (UCB0STAT & UCBUSY);                // wait until I2C module has
                                            // finished all operations.

  // Execute until no more data in Data buffer
  while(moreDataToRead)
  {
    adr_hi = currentAddress >> 8;           // calculate high byte
    adr_lo = currentAddress & 0xFF;         // and low byte of address

    // Chop data down to 64-byte packets to be transmitted at a time
    // Maintain pointer of current startaddress
    if(currentSize > MAXPAGEWRITE)
    {
      bufferPtr = bufferPtr + MAXPAGEWRITE;
      counterI2cBuffer = MAXPAGEWRITE - 1;
      PtrTransmit = MAXPAGEWRITE + 1;       // set I2CBufferArray Pointer
      currentSize = currentSize - MAXPAGEWRITE;
      currentAddress = currentAddress + MAXPAGEWRITE;

      // Get start address
      I2CBufferArray[MAXPAGEWRITE + 1] = adr_hi; // High byte address.
      I2CBufferArray[MAXPAGEWRITE] = adr_lo; // Low byte address.
    }
    else
    {
      bufferPtr = bufferPtr + currentSize;
      counterI2cBuffer = currentSize - 1;
      PtrTransmit = currentSize + 1;        // set I2CBufferArray Pointer.
      moreDataToRead = 0;
      currentAddress = currentAddress + currentSize;

      // Get start address
      I2CBufferArray[currentSize + 1] = adr_hi; // High byte address.
      I2CBufferArray[currentSize] = adr_lo; // Low byte address.
    }

    // Copy data to I2CBufferArray
    unsigned char temp;
    for(i ; i < bufferPtr ; i++)
    {
      temp = Data[i];                       // Required or else IAR throws a
                                            // warning [Pa082]
      I2CBufferArray[counterI2cBuffer] = temp;
      counterI2cBuffer--;
    }

    I2CWriteInit();
    UCB0CTL1 |= UCTXSTT;                    // start condition generation
                                            // => I2C communication is started
    __bis_SR_register(LPM0_bits + GIE);     // Enter LPM0 w/ interrupts
    UCB0CTL1 |= UCTXSTP;                    // I2C stop condition
    while(UCB0CTL1 & UCTXSTP);              // Ensure stop condition got sent

    EEPROM_AckPolling();                    // Ensure data is written in EEPROM
  }
}
*/
/*----------------------------------------------------------------------------*/
// Description:
//   Current Address Read Operation. Data is read from the EEPROM. The current
//   address from the EEPROM is used.
/*----------------------------------------------------------------------------*/
unsigned char EEPROM_CurrentAddressRead(void)
{
	rx_remain = 0;
	////////
/*
	 I2CBufferArray[1] = 0;               // store single bytes that have to
	  I2CBufferArray[0] = 0;               // be sent in the I2CBuffer.
	  PtrTransmit = 0;                          // set I2CBufferArray Pointer

	  // Write Address first
	  I2CWriteInit();
	  UCB0CTL1 |= UCTXSTT;                      // start condition generation
	                                            // => I2C communication is started
	 // __bis_SR_register(LPM0_bits + GIE);       // Enter LPM0 w/ interrupts

*/
	////////////

  while(UCB0STAT & UCBUSY);                 // wait until I2C module has
                                            // finished all operations
  _delay_cycles(1000);
  I2CReadInit();

  UCB0CTL1 |= UCTXSTT;                      // I2C start condition
  while(UCB0CTL1 & UCTXSTT);                // Start condition sent?
  UCB0CTL1 |= UCTXSTP;                      // I2C stop condition
  __bis_SR_register(LPM0_bits + GIE);       // Enter LPM0 w/ interrupts
  while(UCB0CTL1 & UCTXSTP);                // Ensure stop condition got sent
  return I2CBuffer;
}

/*----------------------------------------------------------------------------*/
// Description:
//   Random Read Operation. Data is read from the EEPROM. The EEPROM
//   address is defined with the parameter Address.
/*----------------------------------------------------------------------------*/
unsigned char EEPROM_RandomRead(unsigned int Address)
{
  unsigned char adr_hi;
  unsigned char adr_lo;
  rx_remain = 0;

  while (UCB0STAT & UCBUSY);                // wait until I2C module has
                                            // finished all operations

  adr_hi = Address >> 8;                    // calculate high byte
  adr_lo = Address & 0xFF;                  // and low byte of address

  I2CBufferArray[1] = adr_hi;               // store single bytes that have to
  I2CBufferArray[0] = adr_lo;               // be sent in the I2CBuffer.
  PtrTransmit = 0;                          // set I2CBufferArray Pointer

  // Write Address first
  I2CWriteInit();
  UCB0CTL1 |= UCTXSTT;                      // start condition generation
                                            // => I2C communication is started
  __bis_SR_register(LPM0_bits + GIE);       // Enter LPM0 w/ interrupts

  // Read Data byte
  I2CReadInit();

  UCB0CTL1 |= UCTXSTT;                      // I2C start condition
  while(UCB0CTL1 & UCTXSTT);                // Start condition sent?
  UCB0CTL1 |= UCTXSTP;                      // I2C stop condition
  __bis_SR_register(LPM0_bits + GIE);       // Enter LPM0 w/ interrupts
  //while(UCB0CTL1 & UCTXSTP);                // Ensure stop condition got sent
  return I2CBuffer;
}

/*----------------------------------------------------------------------------*/
// Description:
//   Sequential Read Operation. Data is read from the EEPROM in a sequential
//   form from the parameter address as a starting point. Specify the size to
//   be read and populate to a Data buffer.
/*----------------------------------------------------------------------------*/
void EEPROM_SequentialRead(unsigned int Address , unsigned char * Data , unsigned int Size)
{
  unsigned char adr_hi;
  unsigned char adr_lo;
  //unsigned int counterSize;

  while (UCB0STAT & UCBUSY);                // wait until I2C module has
                                            // finished all operations

  adr_hi = Address >> 8;                    // calculate high byte
  adr_lo = Address & 0xFF;                  // and low byte of address

  I2CBufferArray[1] = adr_hi;               // store single bytes that have to
  I2CBufferArray[0] = adr_lo;               // be sent in the I2CBuffer.
  PtrTransmit = 0;                          // set I2CBufferArray Pointer

  // Write Address first
  I2CWriteInit();
  UCB0CTL1 |= UCTXSTT;                      // start condition generation
                                            // => I2C communication is started
  __bis_SR_register(LPM0_bits + GIE);       // Enter LPM0 w/ interrupts

  rx_remain = Size;
  rx_ptr = Data;

  // Read Data byte
  I2CReadInit();

  UCB0CTL1 |= UCTXSTT;                      // I2C start condition
  while(UCB0CTL1 & UCTXSTT);                // Start condition sent?
  __bis_SR_register(LPM0_bits + GIE);

  //for(counterSize = 0 ; counterSize < Size ; counterSize++)
  //{
  //  __bis_SR_register(LPM0_bits + GIE);     // Enter LPM0 w/ interrupts
  //  Data[counterSize] = I2CBuffer;
  //}
  //UCB0CTL1 |= UCTXSTP;                      // I2C stop condition
  //__bis_SR_register(LPM0_bits + GIE);       // Enter LPM0 w/ interrupts
  //while(UCB0CTL1 & UCTXSTP);                // Ensure stop condition got sent
}

/*----------------------------------------------------------------------------*/
// Description:
//   Acknowledge Polling. The EEPROM will not acknowledge if a write cycle is
//   in progress. It can be used to determine when a write cycle is completed.
/*----------------------------------------------------------------------------*/
/*
void EEPROM_AckPolling(void)
{
  while (UCB0STAT & UCBUSY);                // wait until I2C module has
                                            // finished all operations
  do
  {
    UCB0STAT = 0x00;                        // clear I2C interrupt flags
    UCB0CTL1 |= UCTR;                       // I2CTRX=1 => Transmit Mode (R/W bit = 0)
    UCB0CTL1 &= ~UCTXSTT;
    UCB0CTL1 |= UCTXSTT;                    // start condition is generated
    while(UCB0CTL1 & UCTXSTT)               // wait till I2CSTT bit was cleared
    {
      if(!(UCNACKIFG & UCB0STAT))           // Break out if ACK received
        break;
    }
    UCB0CTL1 |= UCTXSTP;                    // stop condition is generated after
                                            // slave address was sent => I2C communication is started
    while (UCB0CTL1 & UCTXSTP);             // wait till stop bit is reset
    __delay_cycles(500);                    // Software delay
  }while(UCNACKIFG & UCB0STAT);
}
*/
/*---------------------------------------------------------------------------*/
/*  Interrupt Service Routines                                               */
/*     Note that the Compiler version is checked in the following code and   */
/*     depending of the Compiler Version the correct Interrupt Service       */
/*     Routine definition is used.                                           */

#pragma vector=USCI_B0_VECTOR
__interrupt void TX_ISR_I2C(void)

{
	switch(__even_in_range(UCB0IV,12))
	{
	  case  0: break;                           // Vector  0: No interrupts
	  case  2: break;                           // Vector  2: ALIFG
	  case  4: break;                           // Vector  4: NACKIFG
	  case  6: break;                           // Vector  6: STTIFG
	  case  8: break;                           // Vector  8: STPIFG
	  case 10:                                  // Vector 10: RXIFG
		  I2CBuffer = UCB0RXBUF;                  // store received data in buffer

		  if (rx_remain)
		  {
			  *rx_ptr++ = I2CBuffer;
			  if (rx_remain == 1)
				  UCB0CTL1 |= UCTXSTP;
			  rx_remain--;
		  }
		  else
		     __bic_SR_register_on_exit(LPM0_bits);   // Exit LPM0

	    break;
	  case 12: 		                          // Vector 12: TXIFG
		  UCB0TXBUF = I2CBufferArray[PtrTransmit];// Load TX buffer
	      PtrTransmit--;                          // Decrement TX byte counter
	      if(PtrTransmit < 0)
	      {
	        while(!(UCB0IFG & UCTXIFG));
	        UCB0IE &= ~UCTXIE;                     // disable interrupts.
	        UCB0IFG &= ~UCTXIFG;                   // Clear USCI_B0 TX int flag
	        __bic_SR_register_on_exit(LPM0_bits); // Exit LPM0
	      }
	      break;
	  default: break;
	  }

/*
  if(UCTXIFG & UCB0IFG)
  {
    UCB0TXBUF = I2CBufferArray[PtrTransmit];// Load TX buffer
    PtrTransmit--;                          // Decrement TX byte counter
    if(PtrTransmit < 0)
    {
      while(!(UCB0IFG & UCTXIFG));
      UCB0IE &= ~UCTXIE;                     // disable interrupts.
      UCB0IFG &= ~UCTXIFG;                   // Clear USCI_B0 TX int flag
      __bic_SR_register_on_exit(LPM0_bits); // Exit LPM0
    }
  }
  else if(UCRXIFG & UCB0IFG)
  {
    I2CBuffer = UCB0RXBUF;                  // store received data in buffer
    __bic_SR_register_on_exit(LPM0_bits);   // Exit LPM0
  }*/
}
