suspaceflight/rocket-logger/firmware-rx/lcd.c

/*  Author: Steve Gunn
 * Licence: This work is licensed under the Creative Commons Attribution License.
 *           View this license at http://creativecommons.org/about/licenses/
 */
 
#include "ili934x.h"
#include "font.h"
#include "lcd.h"

lcd display = {LCDWIDTH, LCDHEIGHT, North, 0, 0, WHITE, BLACK};

void init_lcd()
{
	/* Disable JTAG in software, so that it does not interfere with Port C  */
	/* It will be re-enabled after a power cycle if the JTAGEN fuse is set. */
	MCUCR |= (1<<JTD);
	MCUCR |= (1<<JTD);
	
	/* Configure ports */
	CTRL_DDR = 0x7F;
	DATA_DDR = 0xFF;
	
	init_display_controller();
}

void set_orientation(orientation o)
{
	display.orient = o;
	write_cmd(MEMORY_ACCESS_CONTROL);
	if (o==North) { 
		display.width = LCDWIDTH;
		display.height = LCDHEIGHT;
		write_data(0x48);
	}
	else if (o==West) {
		display.width = LCDHEIGHT;
		display.height = LCDWIDTH;
		write_data(0xE8);
	}
	else if (o==South) {
		display.width = LCDWIDTH;
		display.height = LCDHEIGHT;
		write_data(0x88);
	}
	else if (o==East) {
		display.width = LCDHEIGHT;
		display.height = LCDWIDTH;
		write_data(0x28);
	}
	write_cmd(COLUMN_ADDRESS_SET);
	write_data16(0);
	write_data16(display.width-1);
	write_cmd(PAGE_ADDRESS_SET);
	write_data16(0);
	write_data16(display.height-1);
}

void fill_rectangle(rectangle r, uint16_t col)
{
	uint16_t x, y;
	write_cmd(COLUMN_ADDRESS_SET);
	write_data16(r.left);
	write_data16(r.right);
	write_cmd(PAGE_ADDRESS_SET);
	write_data16(r.top);
	write_data16(r.bottom);
	write_cmd(MEMORY_WRITE);
	for(x=r.left; x<=r.right; x++)
		for(y=r.top; y<=r.bottom; y++)
			write_data16(col);
}

void fill_rectangle_indexed(rectangle r, uint16_t* col)
{
	uint16_t x, y;
	write_cmd(COLUMN_ADDRESS_SET);
	write_data16(r.left);
	write_data16(r.right);
	write_cmd(PAGE_ADDRESS_SET);
	write_data16(r.top);
	write_data16(r.bottom);
	write_cmd(MEMORY_WRITE);
	for(x=r.left; x<=r.right; x++)
		for(y=r.top; y<=r.bottom; y++)
			write_data16(*col++);
}

void clear_screen()
{
	display.x = 0;
	display.y = 0;
	rectangle r = {0, display.width-1, 0, display.height-1};
	fill_rectangle(r, display.background);
}


static uint8_t stretch_up(uint8_t in)
{
//0b 0000abcd into 0b aabbccdd

    return ((in << 0) & 0x01) | ((in << 1) & 0x02) |
           ((in << 1) & 0x04) | ((in << 2) & 0x08) |
           ((in << 2) & 0x10) | ((in << 3) & 0x20) |
           ((in << 3) & 0x40) | ((in << 4) & 0x80);

}
static uint8_t stretch_down(uint8_t in)
{
//0b abcd0000 into 0b aabbccdd
    return ((in >> 4) & 0x01) | ((in >> 3) & 0x02) |
           ((in >> 3) & 0x04) | ((in >> 2) & 0x08) |
           ((in >> 2) & 0x10) | ((in >> 1) & 0x20) |
           ((in >> 1) & 0x40) | ((in >> 0) & 0x80);

}

void display_char_double(char c)
{

    uint16_t x, y;
    uint8_t i = 0;
	PGM_P fdata; 
	uint8_t bits, mask;
	uint16_t sc=display.x, ec=display.x + 9, sp=display.y, ep=display.y + 7;
	if (c < 32 || c > 126) return;
	fdata = (c - ' ')*5 + font5x7;
	write_cmd(PAGE_ADDRESS_SET);
	write_data16(sp);
	write_data16(ep);
	for(x=sc; x<=ec; x++) {
		write_cmd(COLUMN_ADDRESS_SET);
		write_data16(x);
		write_data16(x);
		write_cmd(MEMORY_WRITE);
		bits = stretch_up(pgm_read_byte(fdata) & 0xF);
        if (i & 1)
            fdata++;
		for(y=sp, mask=0x01; y<=ep; y++, mask<<=1)
			write_data16((bits & mask) ? display.foreground : display.background);
            i++;
	}
	write_cmd(COLUMN_ADDRESS_SET);
	write_data16(x);
	write_data16(x);
	write_cmd(MEMORY_WRITE);
	for(y=sp; y<=ep; y++)
		write_data16(display.background);
        
        
    sp=display.y+8; ep=display.y + 7 + 8;
    fdata = (c - ' ')*5 + font5x7;
	write_cmd(PAGE_ADDRESS_SET);
	write_data16(sp);
	write_data16(ep);
	for(x=sc; x<=ec; x++) {
		write_cmd(COLUMN_ADDRESS_SET);
		write_data16(x);
		write_data16(x);
		write_cmd(MEMORY_WRITE);
		bits = stretch_down(pgm_read_byte(fdata) & 0xF0);
        if (i & 1)
            fdata++;
		for(y=sp, mask=0x01; y<=ep; y++, mask<<=1)
			write_data16((bits & mask) ? display.foreground : display.background);
            i++;
	}
	write_cmd(COLUMN_ADDRESS_SET);
	write_data16(x);
	write_data16(x);
	write_cmd(MEMORY_WRITE);
	for(y=sp; y<=ep; y++)
		write_data16(display.background);

	display.x += 11;
	if (display.x >= display.width) { display.x=0; display.y+=13; }


}

void display_char(char c)
{
	uint16_t x, y;
	PGM_P fdata; 
	uint8_t bits, mask;
	uint16_t sc=display.x, ec=display.x + 4, sp=display.y, ep=display.y + 7;
	if (c < 32 || c > 126) return;
	fdata = (c - ' ')*5 + font5x7;
	write_cmd(PAGE_ADDRESS_SET);
	write_data16(sp);
	write_data16(ep);
	for(x=sc; x<=ec; x++) {
		write_cmd(COLUMN_ADDRESS_SET);
		write_data16(x);
		write_data16(x);
		write_cmd(MEMORY_WRITE);
		bits = pgm_read_byte(fdata++);
		for(y=sp, mask=0x01; y<=ep; y++, mask<<=1)
			write_data16((bits & mask) ? display.foreground : display.background);
	}
	write_cmd(COLUMN_ADDRESS_SET);
	write_data16(x);
	write_data16(x);
	write_cmd(MEMORY_WRITE);
	for(y=sp; y<=ep; y++)
		write_data16(display.background);

	display.x += 6;
	if (display.x >= display.width) { display.x=0; display.y+=8; }
}

void display_string(char *str)
{
	uint8_t i;
	for(i=0; str[i]; i++) 
		display_char(str[i]);
}

void display_string_double(char *str)
{
	uint8_t i;
	for(i=0; str[i]; i++) 
		display_char_double(str[i]);
}
