suspaceflight/rocket-logger/(commit log)

2013-10-13 initial commit of eagle files
    [rocket-logger.brd, rocket-logger.sch]
2013-10-13 now with added flash
    [rocket-logger.brd, rocket-logger.sch]
2013-10-14 added sounder layout
    [rocket-logger.brd, rocket-logger.sch]
2013-10-14 moving stuff around a bit
    [rocket-logger.brd, rocket-logger.sch]
2013-10-14 wired sounder
    [rocket-logger.brd, rocket-logger.sch]
2013-10-15 added mini logger
    [rocket-logger-basic.brd, rocket-logger-basic.sch]
2013-10-17 some routing - changed to smaller flash
    [rocket-logger.brd, rocket-logger.sch]
2013-10-18 adding more leds
    [rocket-logger.brd, rocket-logger.sch]
2013-10-20 removed accel from simple verison, done some routing on main one
    [rocket-logger-basic.brd, rocket-logger-basic.sch, rocket-logger.brd, rocket-logger.sch]
2013-10-20 added charging led
    [rocket-logger-basic.brd, rocket-logger-basic.sch, rocket-logger.brd, rocket-logger.sch]
2013-10-24 done some routing
    [rocket-logger-basic.brd, rocket-logger-basic.sch]
2013-10-26 added diodes on power path
    [rocket-logger.brd, rocket-logger.sch]
2013-10-27 switched to smaller jst connector and done routing
    [rocket-logger-basic.brd, rocket-logger.brd, rocket-logger.sch]
2013-10-28 some more routing
    [rocket-logger.brd]
2013-11-02 some routing done, changed lipo charger
    [rocket-logger-basic.brd, rocket-logger-basic.sch, rocket-logger.brd, rocket-logger.sch]
2013-11-03 moved leds and done silk layer
    [rocket-logger-basic.brd, rocket-logger-basic.sch]
2013-11-18 fixing some drc
    [rocket-logger-basic.brd, rocket-logger.brd]
2013-12-17 minor changes
    [rocket-logger-basic.brd]
2013-12-28 basic logger done
    [rocket-logger-basic.brd, rocket-logger-basic.sch]
2013-12-31 finishing off, almost done
    [rocket-logger-basic.brd, rocket-logger.brd, rocket-logger.sch]
2014-01-06 minor change
    [rocket-logger.brd]
2014-01-07 added merged board
    [rocket-logger-merged.brd]
2014-01-08 sent off
    [rocket-logger-merged.brd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]
2014-04-15 code mostly done but i2c seems broken
    [main.c]
2014-04-16 changes sample rates
2014-09-05 adding battery voltage reporting
2014-10-07 getting power management stuff done
2014-10-09 power mgnt done
2015-01-30 added part values
    [rocket-logger-basic.brd, rocket-logger-basic.sch]
2015-02-17 updating component values
    [rocket-logger-basic.brd, rocket-logger-basic.sch]
2015-02-23 changing value
    [rocket-logger-basic.brd, rocket-logger-basic.sch]
