suspaceflight/rocket-logger/(notices)

Notices in the files:
parts and their libraries:
wuerth-elektronik: Copyright: Würth Elektronik eiSos
SparkFun-PowerIC: Licensing: CC v3.0 Share-Alike You are welcome to use this library for commercial purposes.
